lavignes/nop/hw/kicad/nop.kicad_pcb

## KiCad design hw/kicad/nop.kicad_pcb (2026-09-07)

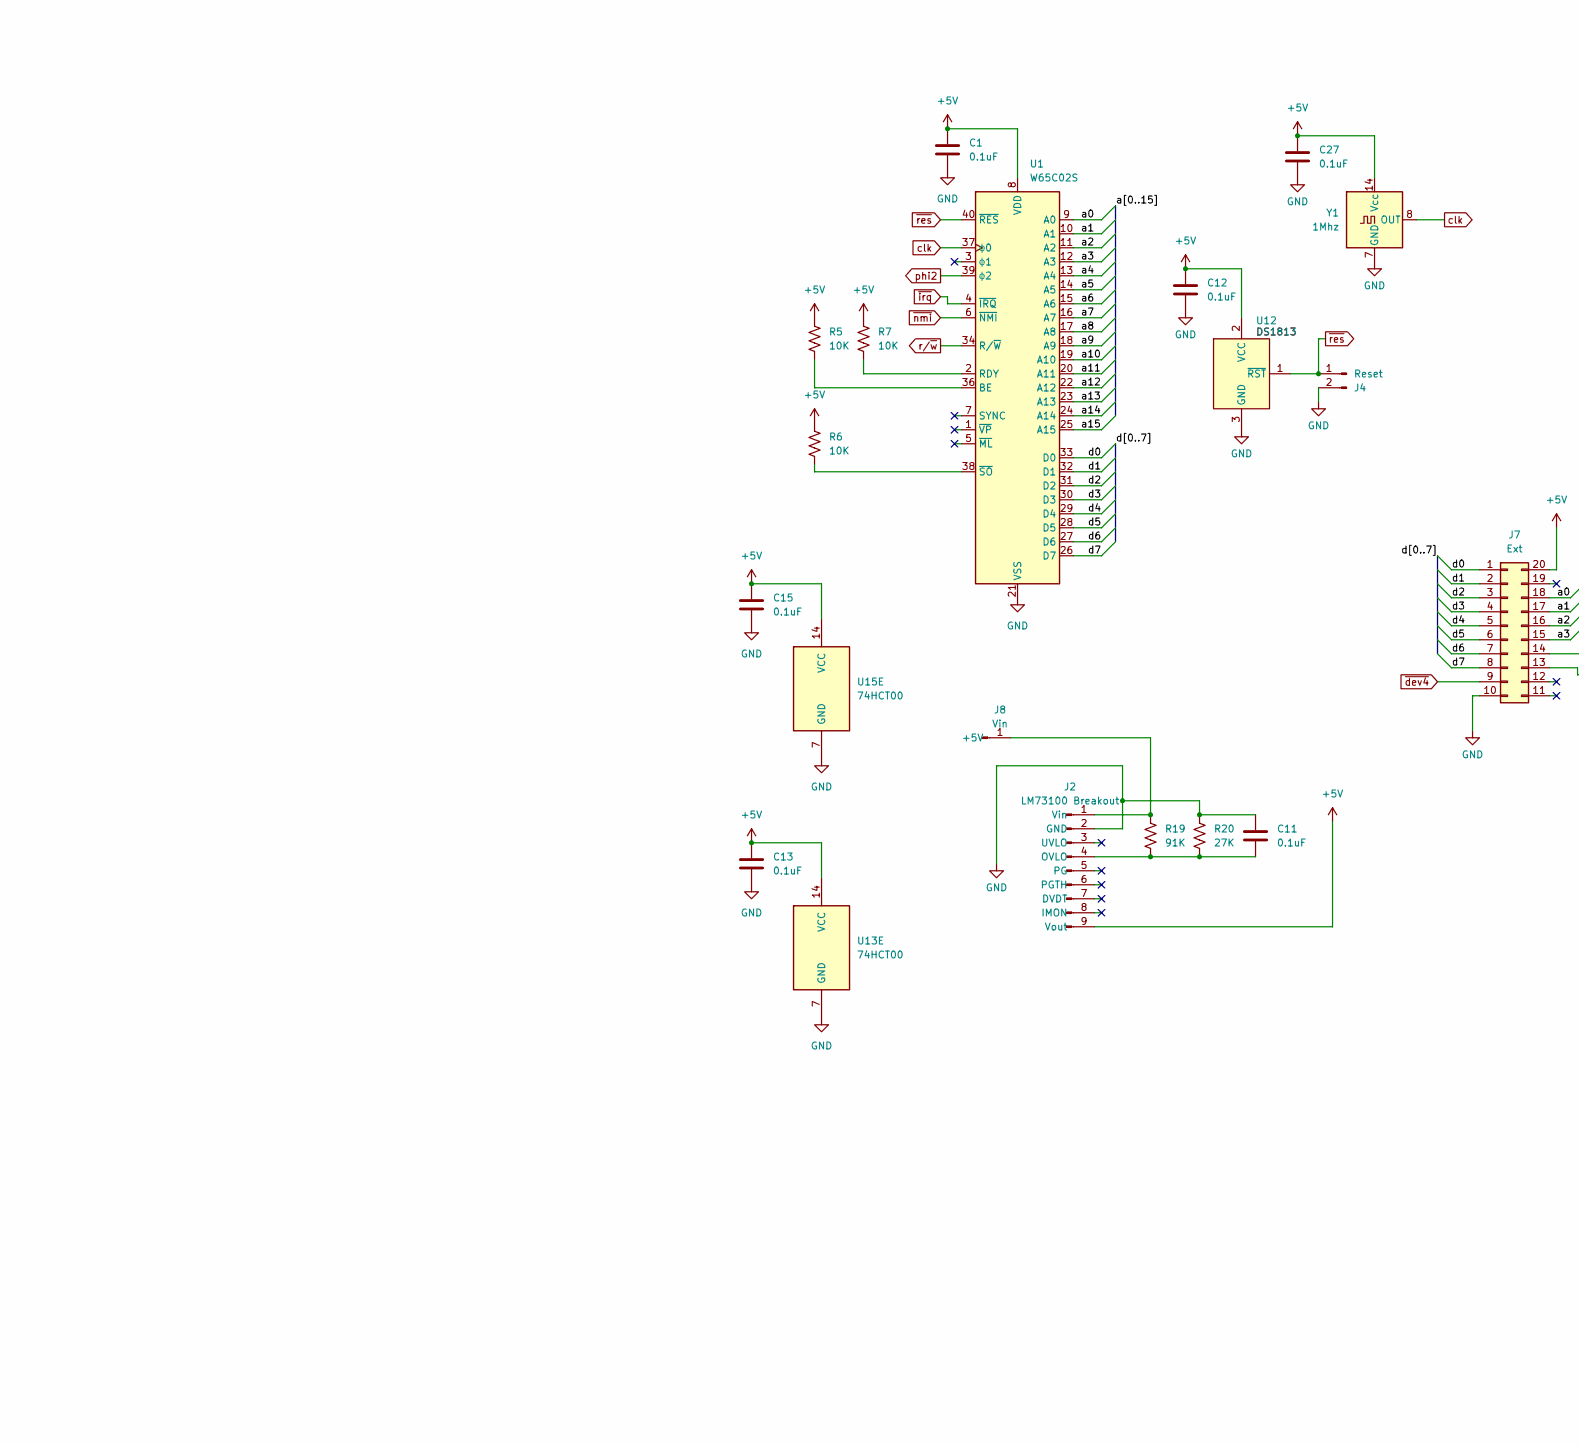
[picture p1: schematic nop.kicad_sch, part in row 1, column 1]

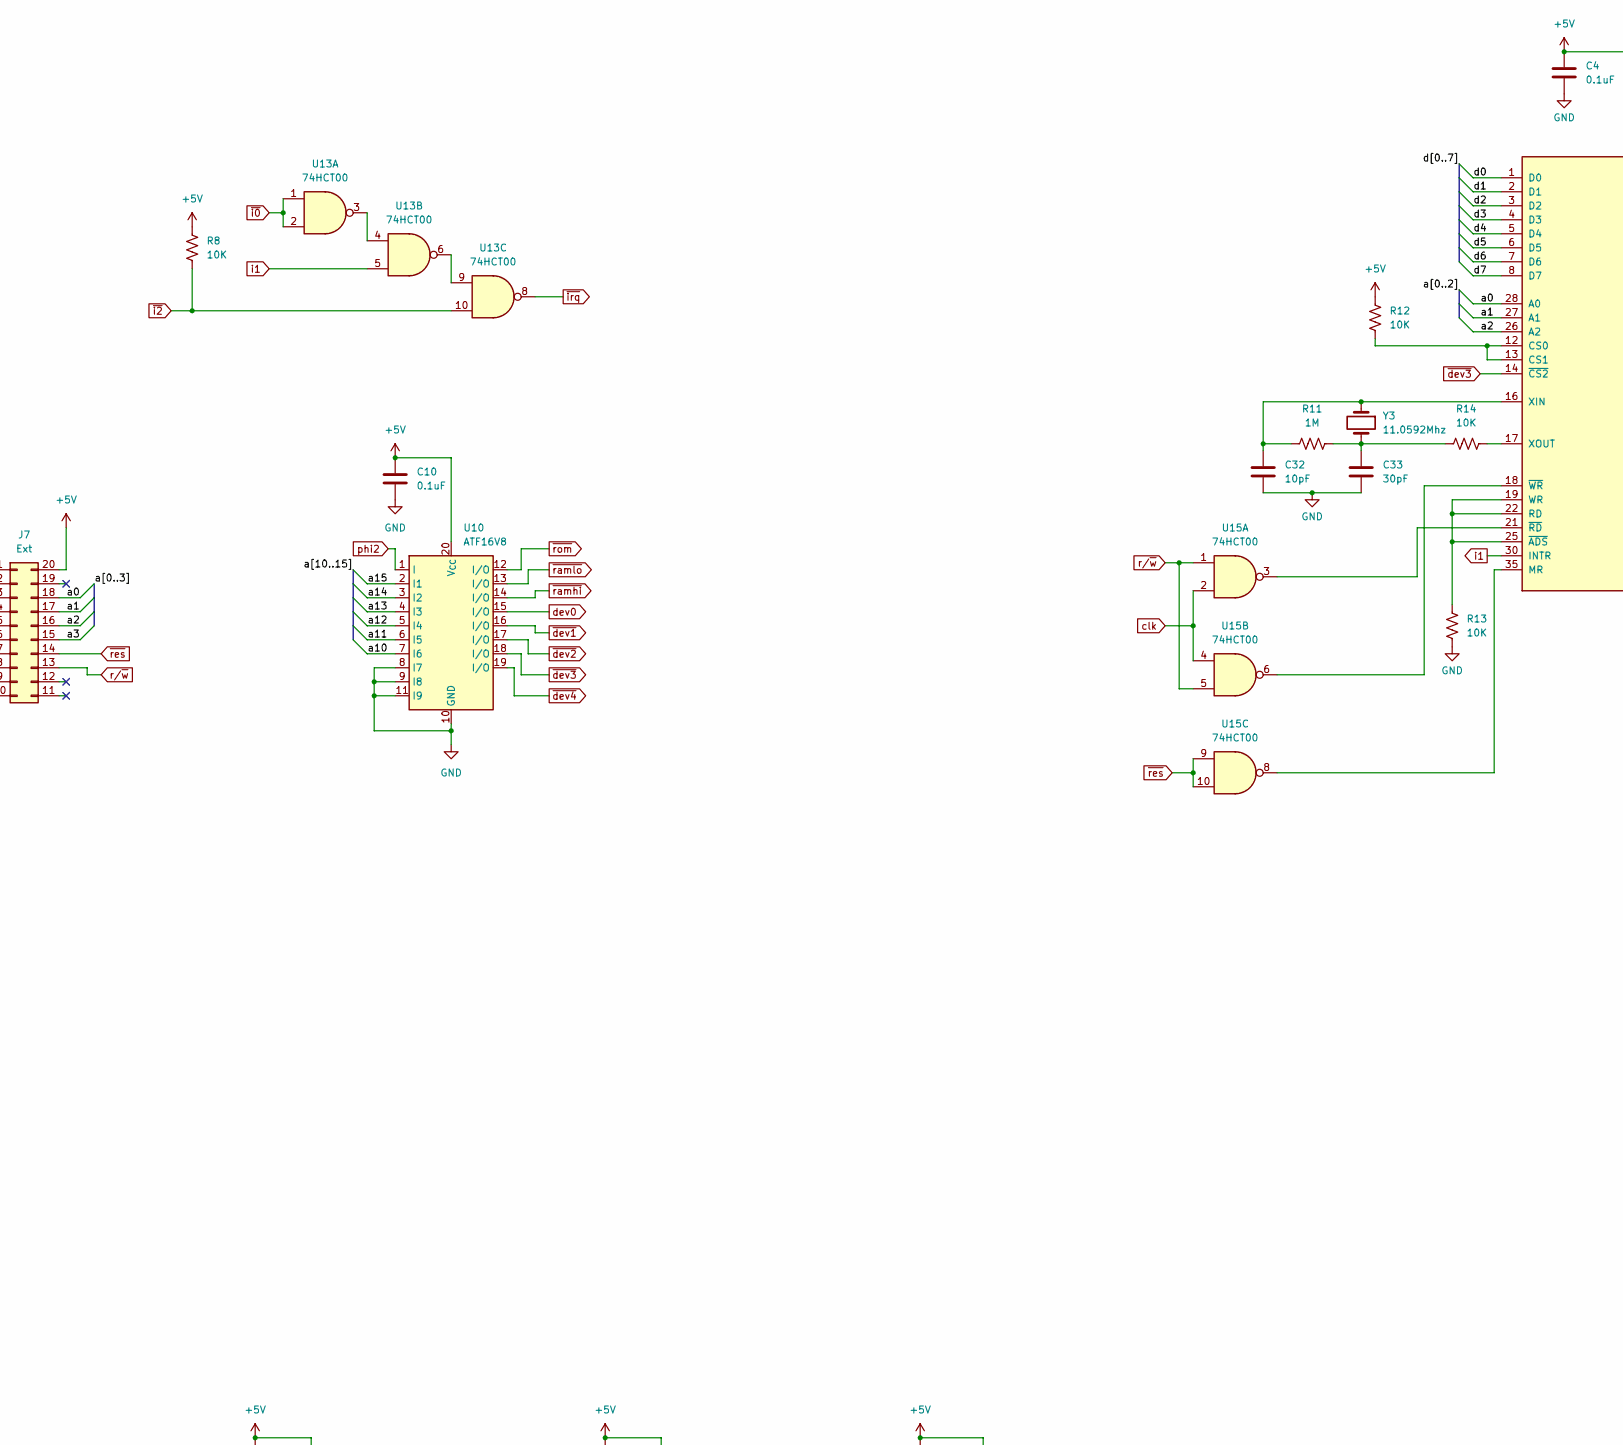
[picture p2: schematic nop.kicad_sch, part in row 1, column 2]

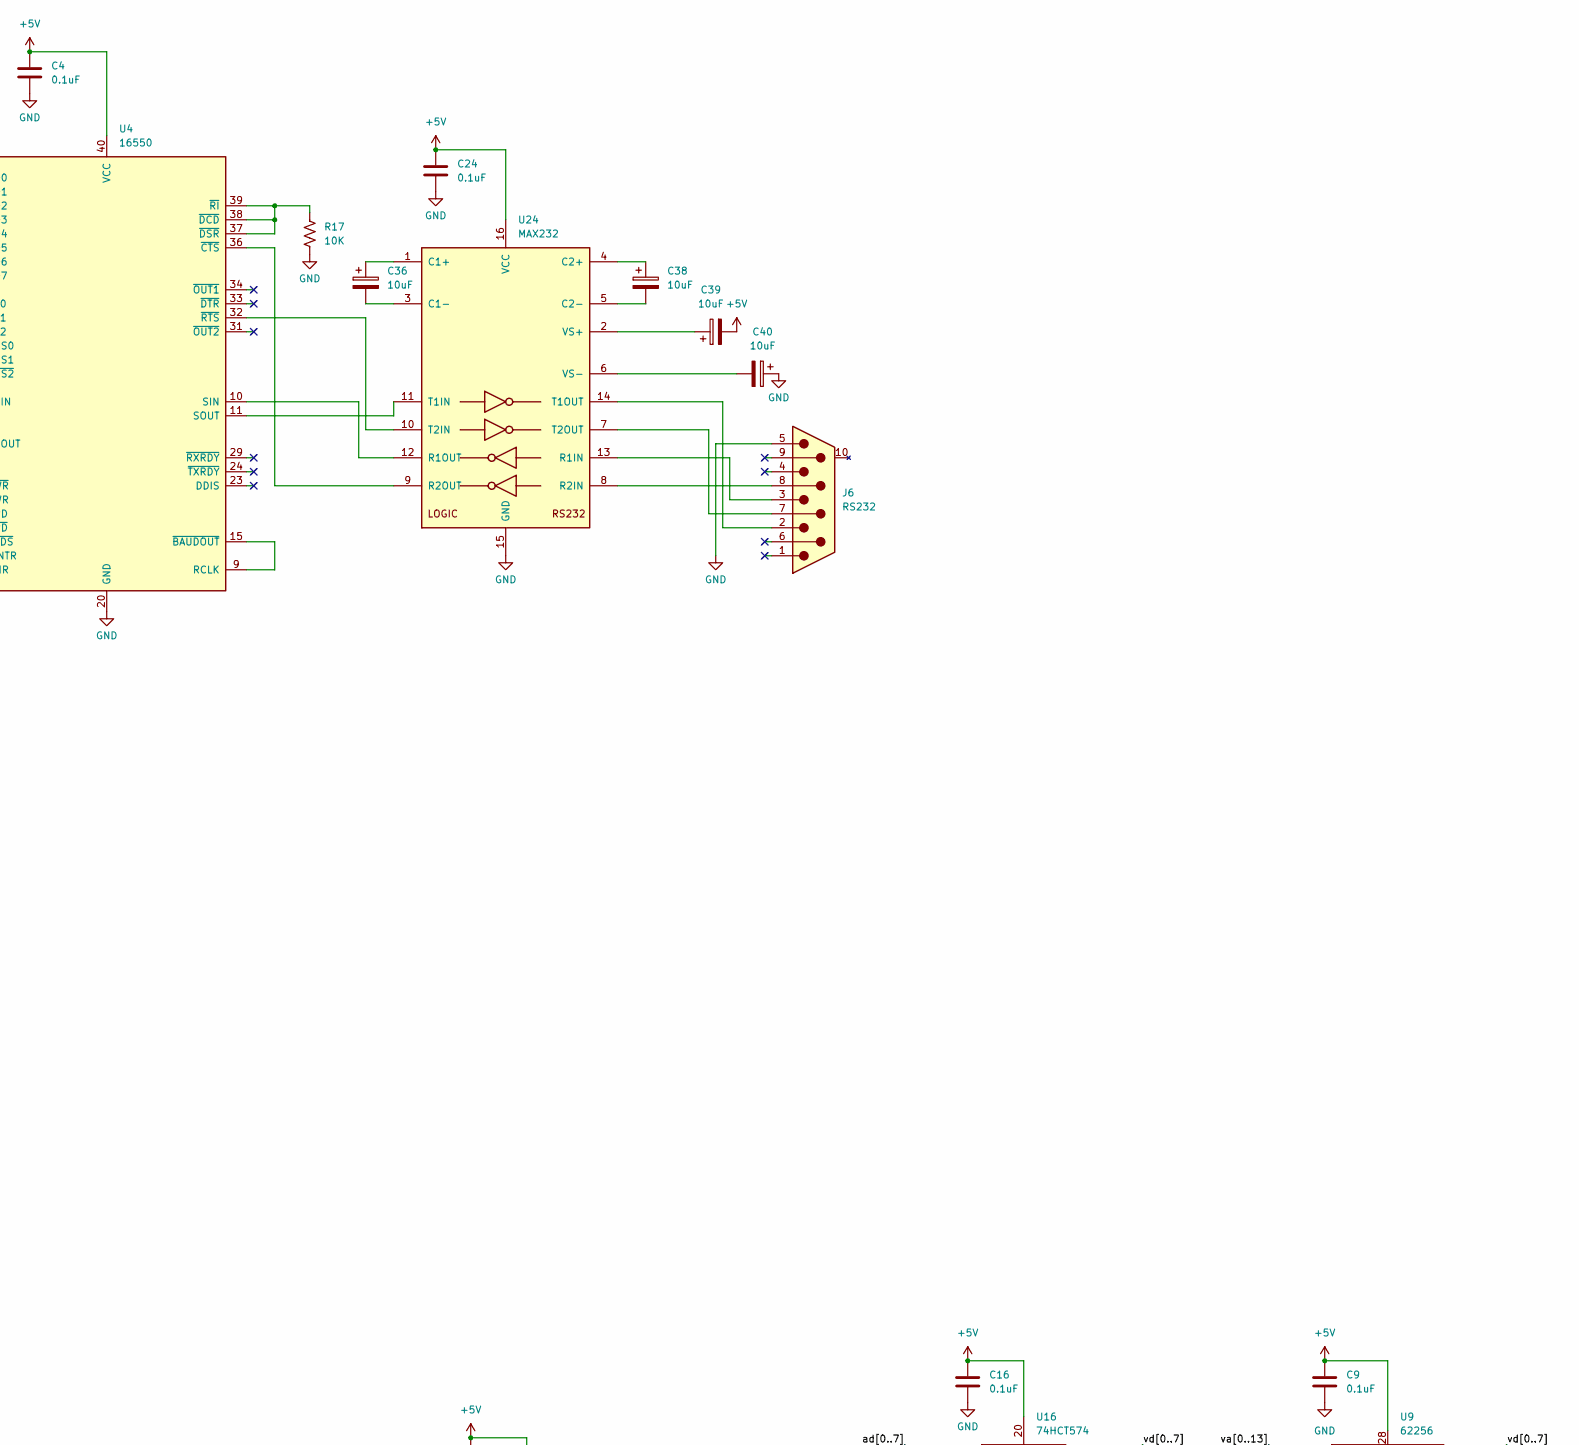
[picture p3: schematic nop.kicad_sch, part in row 1, column 3]

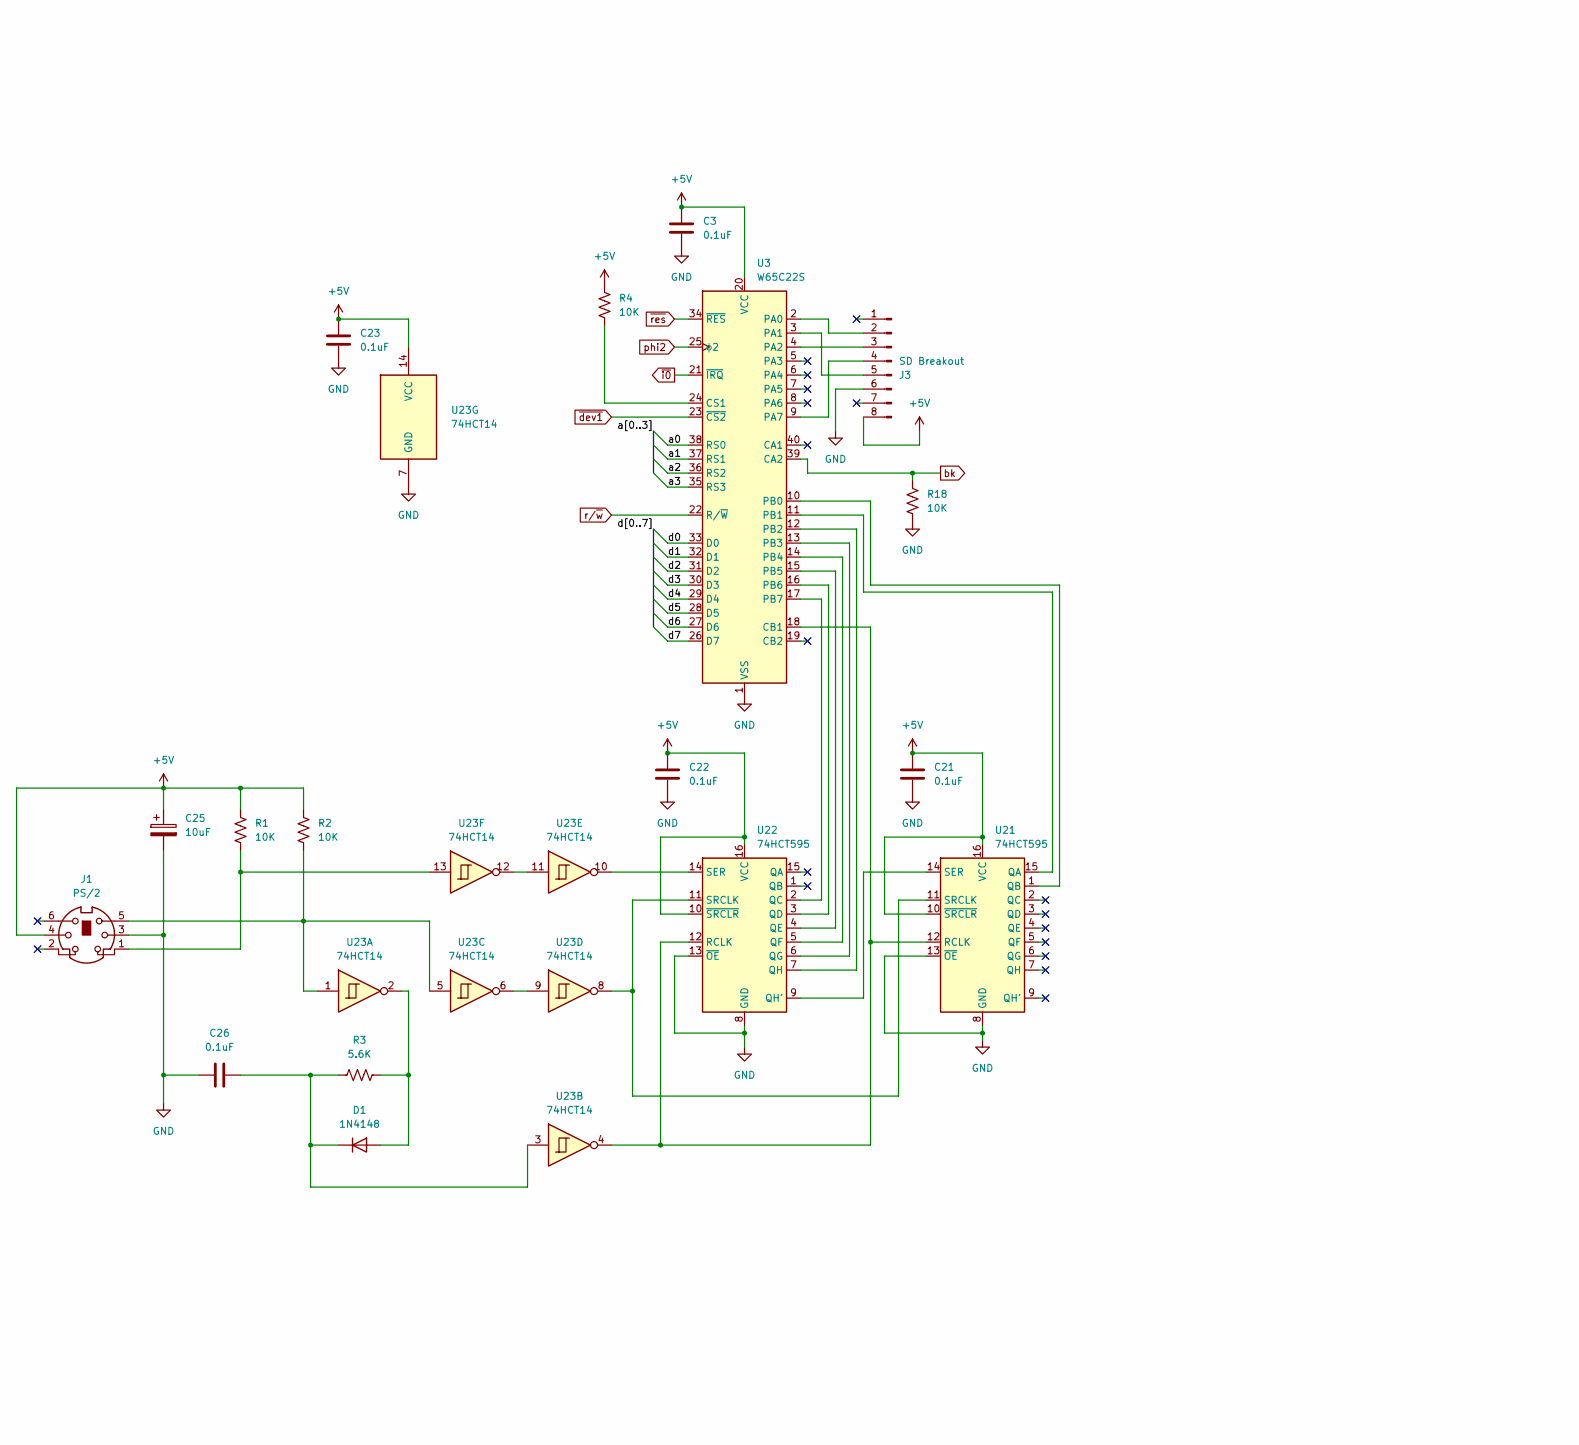
[picture p4: schematic nop.kicad_sch, part in row 2, column 1]

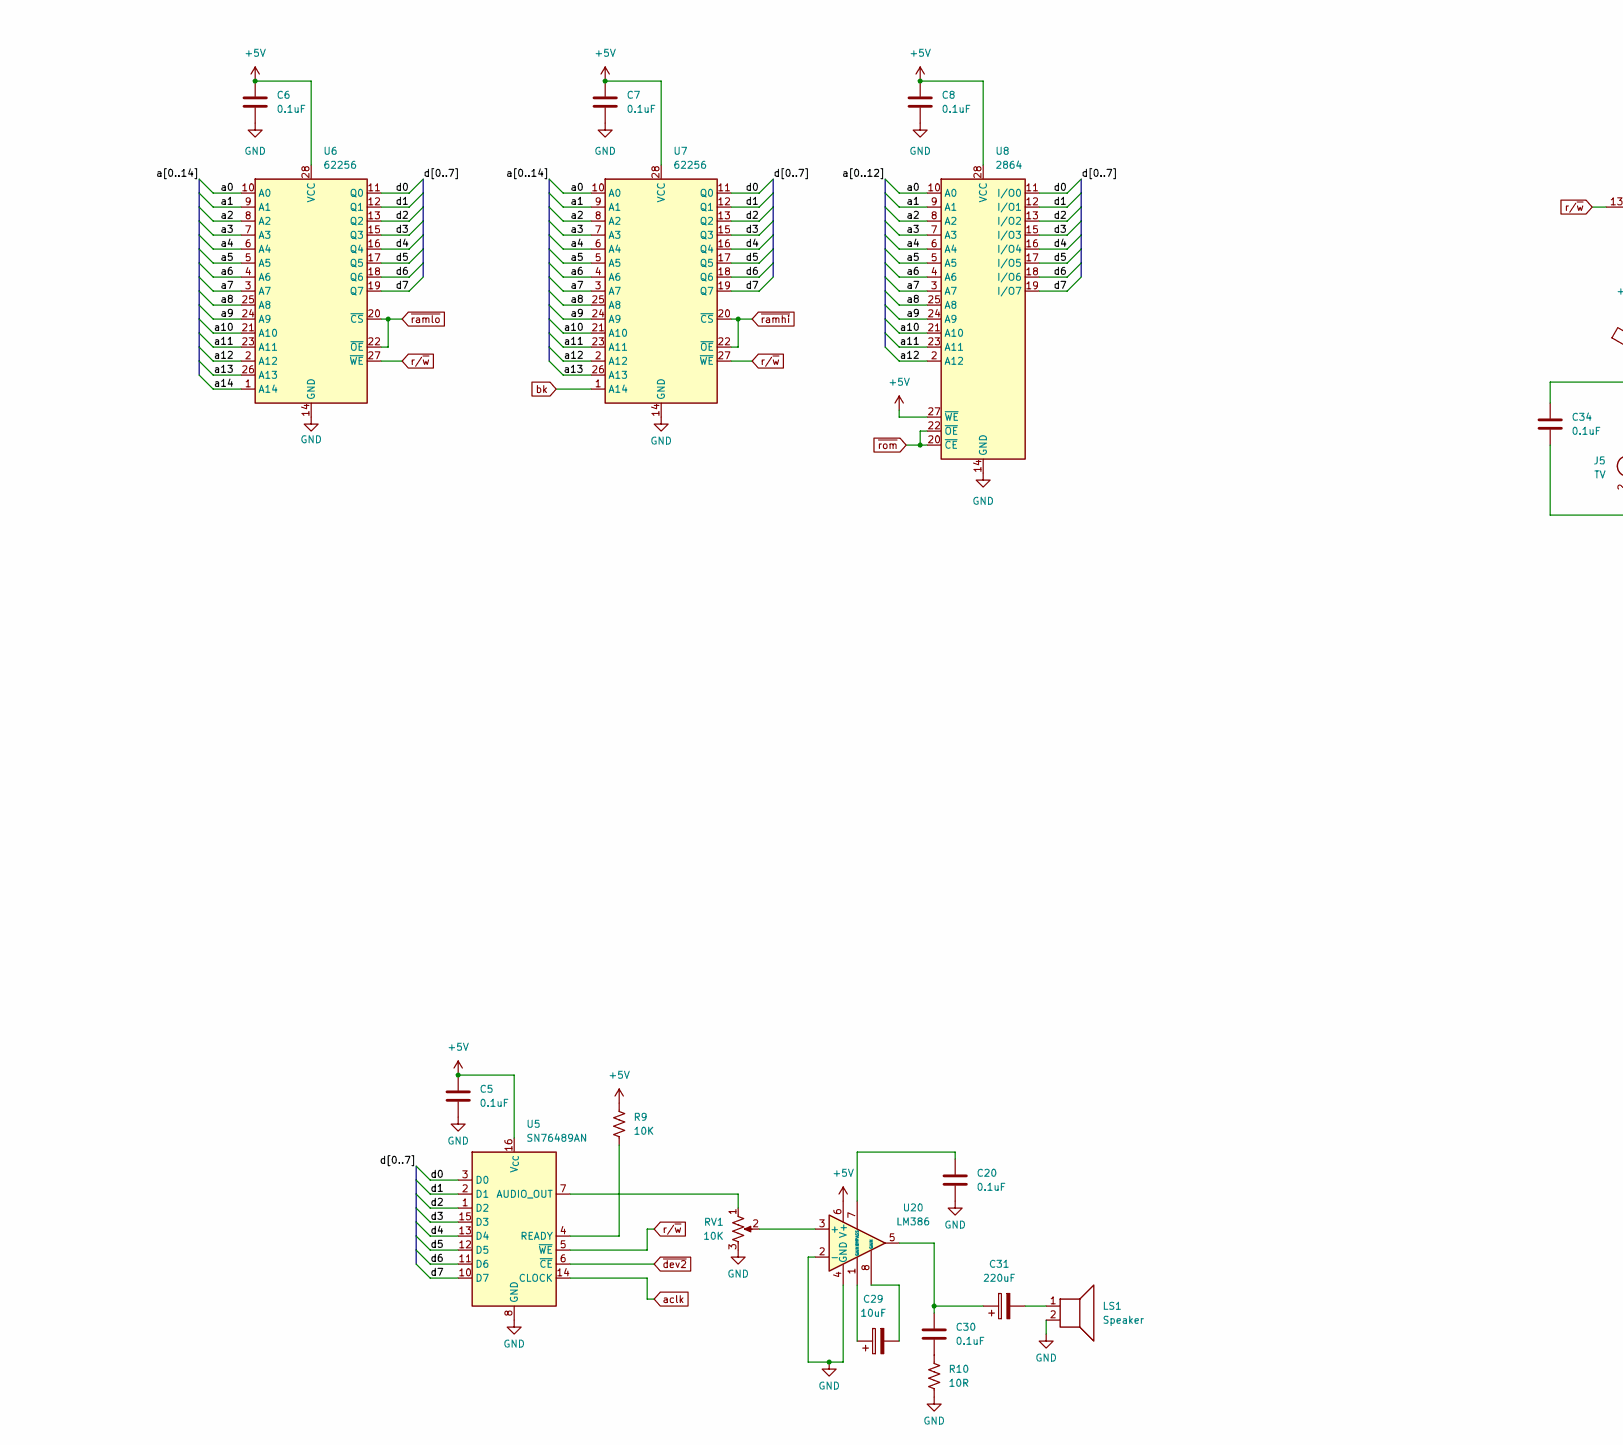
[picture p5: schematic nop.kicad_sch, part in row 2, column 2]

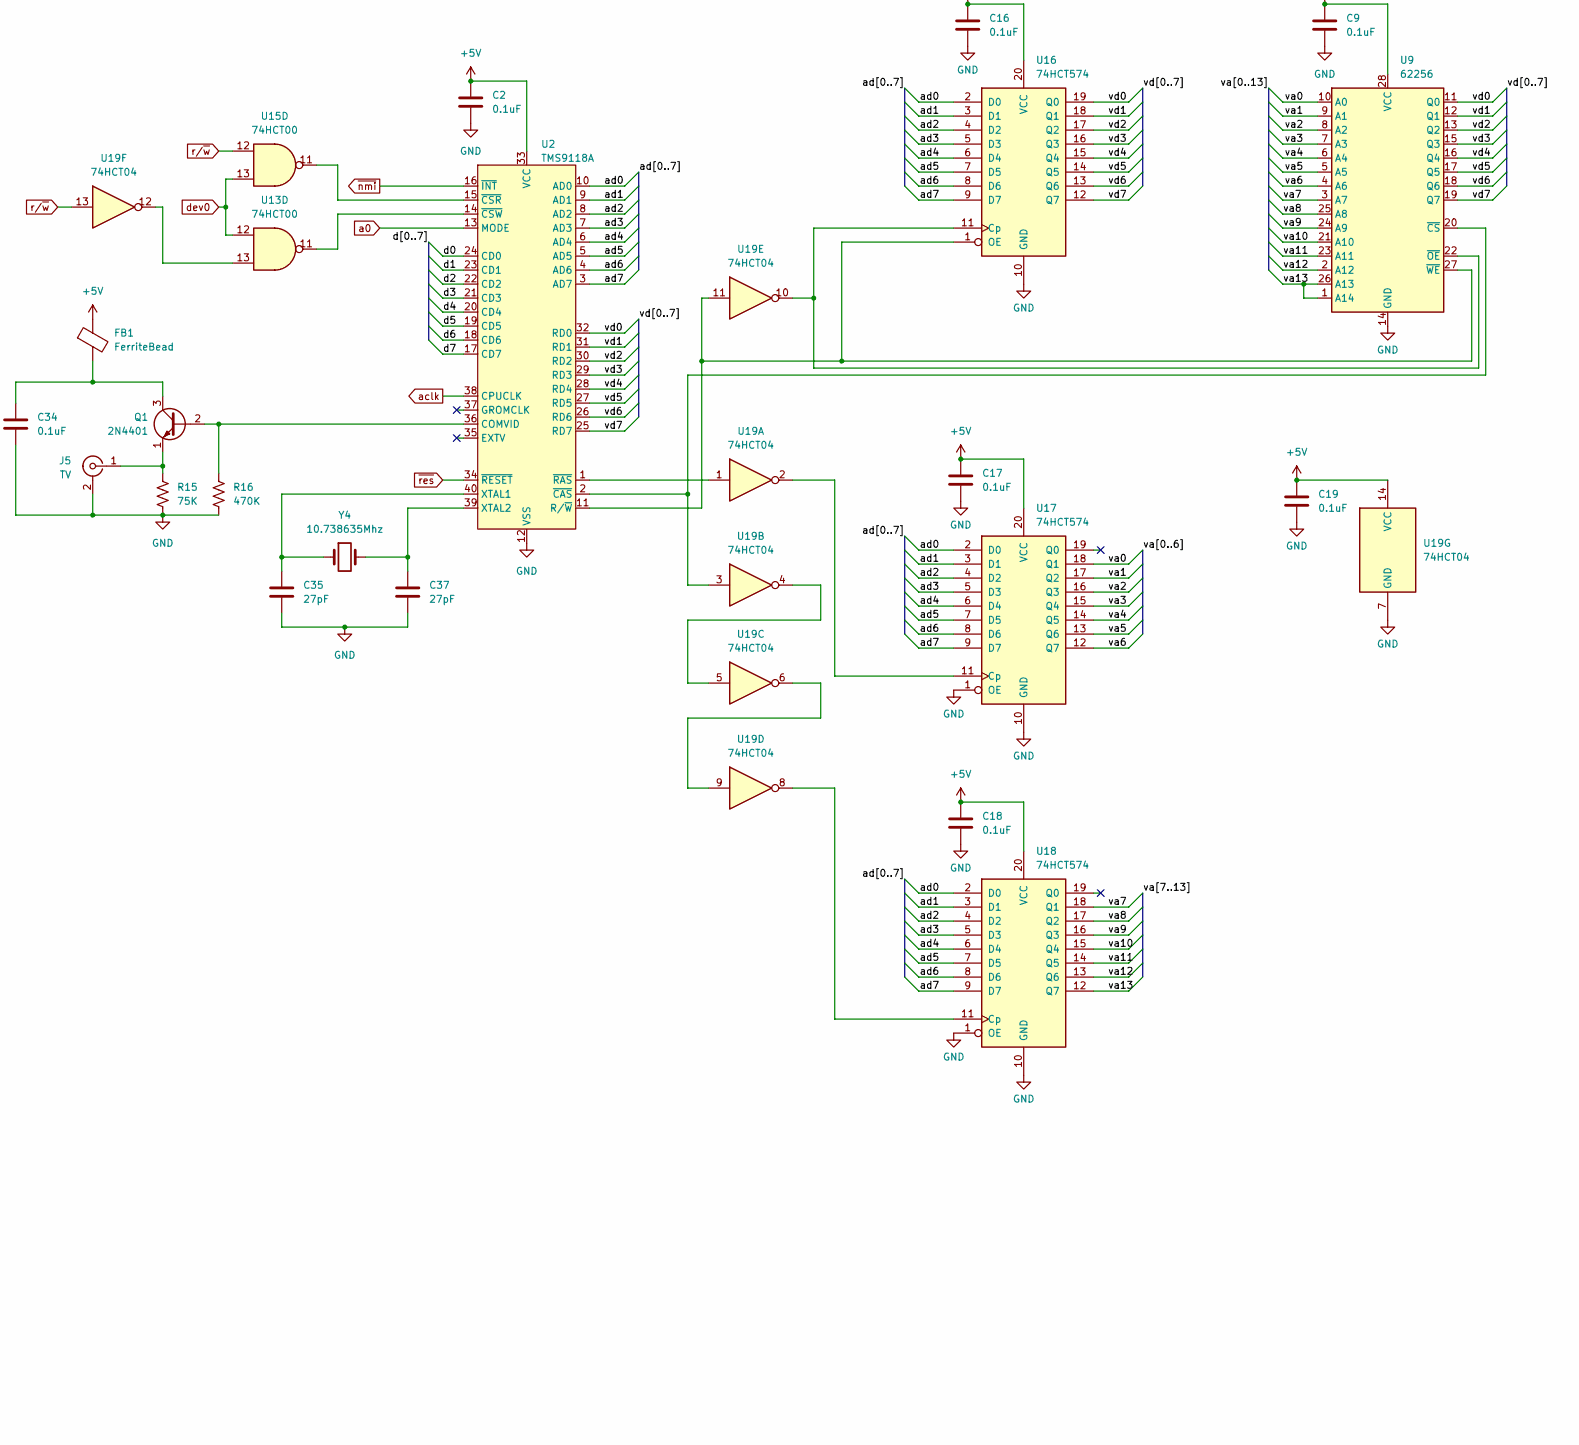
[picture p6: schematic nop.kicad_sch, part in row 2, column 3]

Parts:
C1, C2, C3, C4, C5, C6, C7, C8, C9, C10, C11, C12, C13, C15, C16, C17, C18, C19, C20, C21, C22, C23, C24, C26, C27, C30, C34: 0.1uF; C_Disc_D7.5mm_W4.4mm_P5.00mm
C25, C29, C36, C38, C39, C40: 10uF; CP_Radial_D5.0mm_P2.50mm
C31: 220uF; CP_Radial_D5.0mm_P2.50mm
C32: 10pF; C_Disc_D7.5mm_W4.4mm_P5.00mm
C33: 30pF; C_Disc_D7.5mm_W4.4mm_P5.00mm
C35, C37: 27pF; C_Disc_D7.5mm_W4.4mm_P5.00mm
D1: 1N4148; D_DO-35_SOD27_P7.62mm_Horizontal
FB1: FerriteBead; L_Axial_L5.3mm_D2.2mm_P7.62mm_Horizontal_Vishay_IM-1
J1: PS/2; PinHeader_1x06_P2.54mm_Vertical
J2: LM73100 Breakout; PinHeader_1x09_P2.54mm_Vertical
J3: SD Breakout; PinHeader_1x08_P2.54mm_Vertical
J4: Reset; PinHeader_1x02_P2.54mm_Vertical
J5: TV; PinHeader_1x02_P2.54mm_Vertical
J6: RS232; PinHeader_2x05_P2.54mm_Vertical
J7: Ext; PinHeader_2x10_P2.54mm_Vertical
J8: Vin; PinHeader_1x01_P2.54mm_Vertical
LS1: Speaker; PinHeader_1x02_P2.54mm_Vertical
Q1: 2N4401; TO-92
R1, R2, R4, R5, R6, R7, R8, R9, R12, R13, R14, R17, R18: 10K; R_Axial_DIN0204_L3.6mm_D1.6mm_P7.62mm_Horizontal
R3: 5.6K; R_Axial_DIN0204_L3.6mm_D1.6mm_P7.62mm_Horizontal
R10: 10R; R_Axial_DIN0204_L3.6mm_D1.6mm_P7.62mm_Horizontal
R11: 1M; R_Axial_DIN0204_L3.6mm_D1.6mm_P7.62mm_Horizontal
R15: 75K; R_Axial_DIN0204_L3.6mm_D1.6mm_P7.62mm_Horizontal
R16: 470K; R_Axial_DIN0204_L3.6mm_D1.6mm_P7.62mm_Horizontal
R19: 91K; R_Axial_DIN0204_L3.6mm_D1.6mm_P7.62mm_Horizontal
R20: 27K; R_Axial_DIN0204_L3.6mm_D1.6mm_P7.62mm_Horizontal
RV1: 10K; PinHeader_1x03_P2.54mm_Vertical
U1: W65C02S; DIP-40_W15.24mm_Socket
U2: TMS9118A; DIP-40_W15.24mm_Socket
U3: W65C22S; DIP-40_W15.24mm_Socket
U4: 16550; DIP-40_W15.24mm_Socket
U5: SN76489AN; DIP-16_W7.62mm_Socket
U6, U7, U9: 62256; DIP-28_W15.24mm_Socket
U8: 2864; DIP-28_W15.24mm_Socket
U10: ATF16V8; DIP-20_W7.62mm_Socket
U12: DS1813; TO-92
U13, U15: 74HCT00; DIP-14_W7.62mm_Socket
U16, U17, U18: 74HCT574; DIP-20_W7.62mm_Socket
U19: 74HCT04; DIP-14_W7.62mm_Socket
U20: LM386; DIP-8_W7.62mm_Socket
U21, U22: 74HCT595; DIP-16_W7.62mm_Socket
U23: 74HCT14; DIP-14_W7.62mm_Socket
U24: MAX232; DIP-16_W7.62mm_Socket
Y1: 1Mhz; Oscillator_DIP-14
Y3: 11.0592Mhz; Crystal_HC49-4H_Vertical
Y4: 10.738635Mhz; Crystal_HC49-4H_Vertical

Connections:
+5V: C1.1, C2.1, C3.1, C4.1, C5.1, C6.1, C7.1, C8.1, C9.1, C10.1, C12.1, C13.1, C15.1, C16.1, C17.1, C18.1, C19.1, C21.1, C22.1, C23.1, C24.1, C25.1, C27.1, C39.2, FB1.1, J1.4, J2.9 (Vout), J3.8 (5v), J7.20, R1.2, R2.2, R4.2, R5.2, R6.2, R7.2, R8.2, R9.2, R12.2, U1.8 (VDD), U2.33 (VCC), U3.20 (VCC), U4.40 (VCC), U5.16 (V_{CC}), U6.28 (VCC), U7.28 (VCC), U8.27 (~WE), U8.28 (VCC), U9.28 (VCC), U10.20 (V_{CC}), U12.2 (VCC), U13.14 (VCC), U15.14 (VCC), U16.20 (VCC), U17.20 (VCC), U18.20 (VCC), U19.14 (VCC), U20.6 (V+), U21.10 (~SRCLR), U21.16 (VCC), U22.10 (~SRCLR), U22.16 (VCC), U23.14 (VCC), U24.16 (VCC), Y1.14 (Vcc)
/a1: J7.17, U1.10 (A1), U3.37 (RS1), U4.27 (A1), U6.9 (A1), U7.9 (A1), U8.9 (A1)
/a2: J7.16, U1.11 (A2), U3.36 (RS2), U4.26 (A2), U6.8 (A2), U7.8 (A2), U8.8 (A2)
/a3: J7.15, U1.12 (A3), U3.35 (RS3), U6.7 (A3), U7.7 (A3), U8.7 (A3)
/a4: U1.13 (A4), U6.6 (A4), U7.6 (A4), U8.6 (A4)
/a5: U1.14 (A5), U6.5 (A5), U7.5 (A5), U8.5 (A5)
/a6: U1.15 (A6), U6.4 (A6), U7.4 (A6), U8.4 (A6)
/a7: U1.16 (A7), U6.3 (A7), U7.3 (A7), U8.3 (A7)
/a8: U1.17 (A8), U6.25 (A8), U7.25 (A8), U8.25 (A8)
/a9: U1.18 (A9), U6.24 (A9), U7.24 (A9), U8.24 (A9)
/a10: U1.19 (A10), U6.21 (A10), U7.21 (A10), U8.21 (A10), U10.7 (I6)
/a11: U1.20 (A11), U6.23 (A11), U7.23 (A11), U8.23 (A11), U10.6 (I5)
/a12: U1.22 (A12), U6.2 (A12), U7.2 (A12), U8.2 (A12), U10.5 (I4)
/a13: U1.23 (A13), U6.26 (A13), U7.26 (A13), U10.4 (I3)
/a14: U1.24 (A14), U6.1 (A14), U10.3 (I2)
/a15: U1.25 (A15), U10.2 (I1)
/ad0: U2.10 (AD0), U16.2 (D0), U17.2 (D0), U18.2 (D0)
/ad1: U2.9 (AD1), U16.3 (D1), U17.3 (D1), U18.3 (D1)
/ad2: U2.8 (AD2), U16.4 (D2), U17.4 (D2), U18.4 (D2)
/ad3: U2.7 (AD3), U16.5 (D3), U17.5 (D3), U18.5 (D3)
/ad4: U2.6 (AD4), U16.6 (D4), U17.6 (D4), U18.6 (D4)
/ad5: U2.5 (AD5), U16.7 (D5), U17.7 (D5), U18.7 (D5)
/ad6: U2.4 (AD6), U16.8 (D6), U17.8 (D6), U18.8 (D6)
/ad7: U2.3 (AD7), U16.9 (D7), U17.9 (D7), U18.9 (D7)
/d0: J7.1, U1.33 (D0), U2.24 (CD0), U3.33 (D0), U4.1 (D0), U5.3 (D0), U6.11 (Q0), U7.11 (Q0), U8.11 (I/O0)
/d1: J7.2, U1.32 (D1), U2.23 (CD1), U3.32 (D1), U4.2 (D1), U5.2 (D1), U6.12 (Q1), U7.12 (Q1), U8.12 (I/O1)
/d2: J7.3, U1.31 (D2), U2.22 (CD2), U3.31 (D2), U4.3 (D2), U5.1 (D2), U6.13 (Q2), U7.13 (Q2), U8.13 (I/O2)
/d3: J7.4, U1.30 (D3), U2.21 (CD3), U3.30 (D3), U4.4 (D3), U5.15 (D3), U6.15 (Q3), U7.15 (Q3), U8.15 (I/O3)
/d4: J7.5, U1.29 (D4), U2.20 (CD4), U3.29 (D4), U4.5 (D4), U5.13 (D4), U6.16 (Q4), U7.16 (Q4), U8.16 (I/O4)
/d5: J7.6, U1.28 (D5), U2.19 (CD5), U3.28 (D5), U4.6 (D5), U5.12 (D5), U6.17 (Q5), U7.17 (Q5), U8.17 (I/O5)
/d6: J7.7, U1.27 (D6), U2.18 (CD6), U3.27 (D6), U4.7 (D6), U5.11 (D6), U6.18 (Q6), U7.18 (Q6), U8.18 (I/O6)
/d7: J7.8, U1.26 (D7), U2.17 (CD7), U3.26 (D7), U4.8 (D7), U5.10 (D7), U6.19 (Q7), U7.19 (Q7), U8.19 (I/O7)
/va0: U9.10 (A0), U17.18 (Q1)
/va1: U9.9 (A1), U17.17 (Q2)
/va2: U9.8 (A2), U17.16 (Q3)
/va3: U9.7 (A3), U17.15 (Q4)
/va4: U9.6 (A4), U17.14 (Q5)
/va5: U9.5 (A5), U17.13 (Q6)
/va6: U9.4 (A6), U17.12 (Q7)
/va7: U9.3 (A7), U18.18 (Q1)
/va8: U9.25 (A8), U18.17 (Q2)
/va9: U9.24 (A9), U18.16 (Q3)
/va10: U9.21 (A10), U18.15 (Q4)
/va11: U9.23 (A11), U18.14 (Q5)
/va12: U9.2 (A12), U18.13 (Q6)
/va13: U9.1 (A14), U9.26 (A13), U18.12 (Q7)
/vd0: U2.32 (RD0), U9.11 (Q0), U16.19 (Q0)
/vd1: U2.31 (RD1), U9.12 (Q1), U16.18 (Q1)
/vd2: U2.30 (RD2), U9.13 (Q2), U16.17 (Q2)
/vd3: U2.29 (RD3), U9.15 (Q3), U16.16 (Q3)
/vd4: U2.28 (RD4), U9.16 (Q4), U16.15 (Q4)
/vd5: U2.27 (RD5), U9.17 (Q5), U16.14 (Q5)
/vd6: U2.26 (RD6), U9.18 (Q6), U16.13 (Q6)
/vd7: U2.25 (RD7), U9.19 (Q7), U16.12 (Q7)
GND: C1.2, C2.2, C3.2, C4.2, C5.2, C6.2, C7.2, C8.2, C9.2, C10.2, C11.1, C12.2, C13.2, C15.2, C16.2, C17.2, C18.2, C19.2, C20.2, C21.2, C22.2, C23.2, C24.2, C25.2, C26.1, C27.2, C32.2, C33.2, C34.2, C35.2, C37.2, C40.1, J1.3, J2.2 (GND), J3.6 (GND), J4.2, J5.2 (Ext), J6.5, J7.10, LS1.2, R10.1, R13.1, R15.1, R16.1, R17.1, R18.1, R20.2, RV1.3, U1.21 (VSS), U2.12 (VSS), U3.1 (VSS), U4.20 (GND), U5.8 (GND), U6.14 (GND), U7.14 (GND), U8.14 (GND), U9.14 (GND), U10.8 (I7), U10.9 (I8), U10.10 (GND), U10.11 (I9), U12.3 (GND), U13.7 (GND), U15.7 (GND), U16.10 (GND), U17.1 (OE), U17.10 (GND), U18.1 (OE), U18.10 (GND), U19.7 (GND), U20.2 (-), U20.4 (GND), U21.8 (GND), U21.13 (~OE), U22.8 (GND), U22.13 (~OE), U23.7 (GND), U24.15 (GND), Y1.7 (GND)
unnamed: C29.1, U20.1 (GAIN)
unnamed: C29.2, U20.8 (GAIN)
unnamed: C30.1, C31.1, U20.5
unnamed: C30.2, R10.2
unnamed: C31.2, LS1.1
unnamed: C33.1, R11.1, R14.2, Y3.2
unnamed: D1.2 (A), R3.1, U23.2
unnamed: C26.2, D1.1 (K), R3.2, U23.3
unnamed: J1.1, R1.1, U23.13
unnamed: J1.5, R2.1, U23.1, U23.5
unnamed: C11.2, J2.4 (OVLO), R19.1, R20.1
unnamed: J2.1 (Vin), J8.1, R19.2
unnamed: J3.5 (CLK), U3.3 (PA1)
unnamed: J3.2 (CS), U3.2 (PA0)
unnamed: J3.3 (DI), U3.4 (PA2)
unnamed: J3.4 (DO), U3.9 (PA7)
unnamed: J5.1 (In), Q1.1 (E), R15.2
unnamed: Q1.2 (B), R16.2, U2.36 (COMVID)
unnamed: C34.1, FB1.2, Q1.3 (C)
unnamed: R5.1, U1.36 (BE)
unnamed: R7.1, U1.2 (RDY)
unnamed: R6.1, U1.38 (~SO)
unnamed: C35.1, U2.40 (XTAL1), Y4.1
unnamed: C37.1, U2.39 (XTAL2), Y4.2
unnamed: U2.2 (~CAS), U9.20 (~CS), U19.3
unnamed: U2.15 (~CSR), U15.11
unnamed: U2.14 (~CSW), U13.11
unnamed: U2.1 (~RAS), U19.1
unnamed: R4.1, U3.24 (CS1)
unnamed: R12.1, U4.12 (CS0), U4.13 (CS1)
unnamed: U4.35 (MR), U15.8
unnamed: U4.9 (RCLK), U4.15 (~BAUDOUT)
unnamed: R13.2, U4.19 (WR), U4.22 (RD), U4.25 (~ADS)
unnamed: C32.1, R11.2, U4.16 (XIN), Y3.1
unnamed: R14.1, U4.17 (XOUT)
unnamed: R17.2, U4.37 (~DSR), U4.38 (~DCD), U4.39 (~RI)
unnamed: U4.21 (~RD), U15.3
unnamed: U4.18 (~WR), U15.6
unnamed: RV1.1, U5.7 (AUDIO_OUT)
unnamed: R9.1, U5.4 (READY)
unnamed: U13.3, U13.4
unnamed: U13.6, U13.9
unnamed: U13.13, U19.12
unnamed: U9.22 (~OE), U16.11 (Cp), U19.10
unnamed: U2.11 (R/~W), U9.27 (~WE), U16.1 (OE), U19.11
unnamed: U17.11 (Cp), U19.2
unnamed: U18.11 (Cp), U19.8
unnamed: U19.4, U19.5
unnamed: U19.6, U19.9
unnamed: RV1.2, U20.3 (+)
unnamed: C20.1, U20.7 (BYPASS)
unnamed: U3.11 (PB1), U21.15 (QA)
unnamed: U3.10 (PB0), U21.1 (QB)
unnamed: U3.18 (CB1), U21.12 (RCLK), U22.12 (RCLK), U23.4
unnamed: U21.14 (SER), U22.9 (QH')
unnamed: U21.11 (SRCLK), U22.11 (SRCLK), U23.8
unnamed: U3.17 (PB7), U22.2 (QC)
unnamed: U3.16 (PB6), U22.3 (QD)
unnamed: U3.15 (PB5), U22.4 (QE)
unnamed: U3.14 (PB4), U22.5 (QF)
unnamed: U3.13 (PB3), U22.6 (QG)
unnamed: U3.12 (PB2), U22.7 (QH)
unnamed: U22.14 (SER), U23.10
unnamed: U23.6, U23.9
unnamed: U23.11, U23.12
unnamed: C36.1, U24.1 (C1+)
unnamed: C36.2, U24.3 (C1-)
unnamed: C38.1, U24.4 (C2+)
unnamed: C38.2, U24.5 (C2-)
unnamed: J6.3, U24.13 (R1IN)
unnamed: U4.10 (SIN), U24.12 (R1OUT)
unnamed: J6.8, U24.8 (R2IN)
unnamed: U4.36 (~CTS), U24.9 (R2OUT)
unnamed: U4.11 (SOUT), U24.11 (T1IN)
unnamed: J6.2, U24.14 (T1OUT)
unnamed: U4.32 (~RTS), U24.10 (T2IN)
unnamed: J6.7, U24.7 (T2OUT)
unnamed: C39.1, U24.2 (VS+)
unnamed: C40.2, U24.6 (VS-)
a0: J7.18, U1.9 (A0), U2.13 (MODE), U3.38 (RS0), U4.28 (A0), U6.10 (A0), U7.10 (A0), U8.10 (A0)
aclk: U2.38 (CPUCLK), U5.14 (CLOCK)
bk: R18.2, U3.39 (CA2), U7.1 (A14)
clk: U1.37 (ϕ0), U15.2, U15.4, Y1.8 (OUT)
dev0: U10.15 (I/O), U13.12, U15.13
i1: U4.30 (INTR), U13.5
phi2: U1.39 (ϕ2), U3.25 (ϕ2), U10.1 (I)
r/~w: J7.13, U1.34 (R/~W), U3.22 (R/~W), U5.5 (~WE), U6.27 (~WE), U7.27 (~WE), U15.1, U15.5, U15.12, U19.13
~dev1: U3.23 (~CS2), U10.16 (I/O)
~dev2: U5.6 (~CE), U10.17 (I/O)
~dev3: U4.14 (~CS2), U10.18 (I/O)
~dev4: J7.9, U10.19 (I/O)
~i0: U3.21 (~IRQ), U13.1, U13.2
~i2: R8.1, U13.10
~irq: U1.4 (~IRQ), U13.8
~nmi: U1.6 (~NMI), U2.16 (~INT)
~ramhi: U7.20 (~CS), U7.22 (~OE), U10.14 (I/O)
~ramlo: U6.20 (~CS), U6.22 (~OE), U10.13 (I/O)
~res: J4.1, J7.14, U1.40 (~RES), U2.34 (~RESET), U3.34 (~RES), U12.1 (~RST), U15.9, U15.10
~rom: U8.20 (~CE), U8.22 (~OE), U10.12 (I/O)

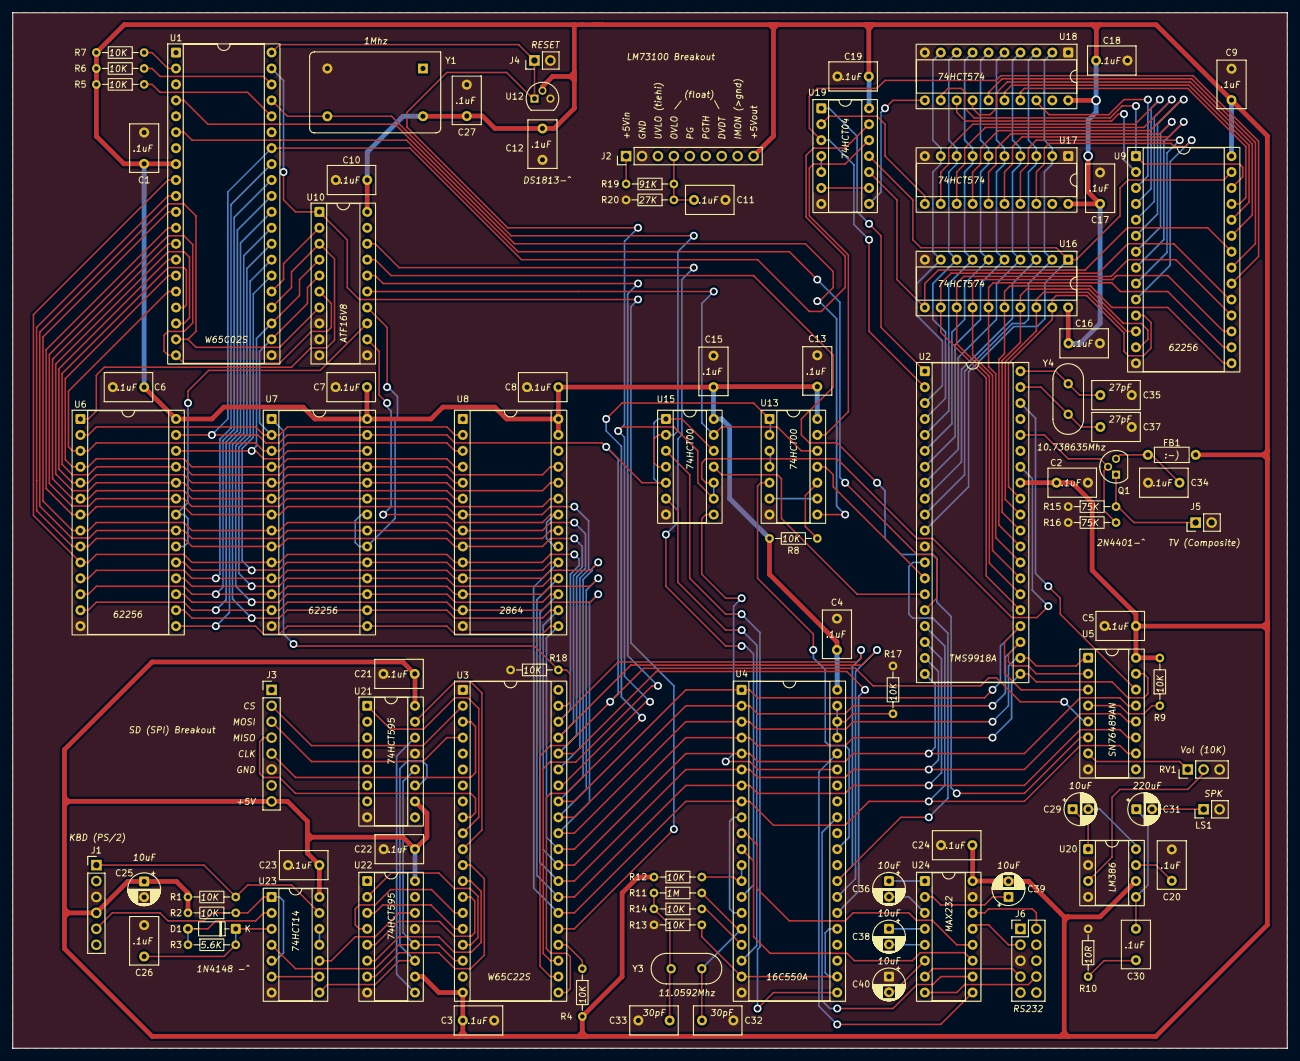
[picture p7: board nop.kicad_pcb from above]

Board: 2 copper layers, 203.2 x 165.1 mm, 94 parts (0 on the bottom side), 153 nets.
