lavignes/nop/vm/vm.c

// stdlib
#include <stddef.h>
#include <stdio.h>
#include <stdlib.h>
#include <string.h>
#include <time.h>

// POSIX
#include <termios.h>
#include <unistd.h>

#include <SDL3/SDL.h>

#include "vm.h"

static void help(char const *name) {
  fprintf(stderr,
          "Usage: %s [options] <rom-file>\n"
          "\n"
          "Options:\n"
          "\n"
          "  -d, --debug              Start in debug mode\n"
          "  -l, --label-list <path>  Load symbol label-list from file\n"
          "  -r, --random             Initialize memory with random data\n"
          "  -i, --image <path>       Attach a disk image\n"
          "  -s, --serial <path>      Attach a serial device or file\n"
          "  -h, --help               Show this help message\n",
          name);
}

static Emu emu = {0};

static struct termios termiosOrig;
static Bool termRawMode = FALSE;

static SDL_Window *win = NULL;
static SDL_Renderer *render = NULL;
static SDL_Texture *tex = NULL;
static SDL_AudioStream *audio = NULL;

enum { AUDIO_BUF_LEN = 4096 };
static I16 audioBuf[AUDIO_BUF_LEN];
static UInt audioLen = 0;

static Bool quit = FALSE;
static UInt cycleCount = 0;
static UInt vdpAccum = 0;
static UInt sampleAccum = 0;
static U64 nextFrameNs = 0;

enum : U64 {
  FRAME_COLS_NTSC = 342,
  FRAME_LINES_NTSC = 262,
  FRAME_TIME_NTSC =
      U64K(1000000000) * FRAME_COLS_NTSC * FRAME_LINES_NTSC / VDP_HZ
};

static void emuReset(Bool random);
static void emuTick();

static void audioFlush();

int main(int argc, char const *const *argv) {
  FILE *rom;
  char const *labelList = NULL;
  char const *diskPath = NULL;
  Bool random = FALSE;

  atexit(termRawModeOff);

  if (argc < 2) {
    help(argv[0]);
    return EXIT_FAILURE;
  }
  for (int argi = 1; argi < argc; ++argi) {
    if ((strcmp(argv[argi], "-h") == 0) ||
        (strcmp(argv[argi], "--help") == 0)) {
      help(argv[0]);
      return EXIT_SUCCESS;
    }
    if ((strcmp(argv[argi], "-d") == 0) ||
        (strcmp(argv[argi], "--debug") == 0)) {
      emu.dbg.debug = TRUE;
      continue;
    }
    if ((strcmp(argv[argi], "-l") == 0) ||
        (strcmp(argv[argi], "--labellist") == 0)) {
      ++argi;
      if (argi == argc) {
        fprintf(stderr, "No labellist file specified\n");
        return EXIT_FAILURE;
      }
      labelList = argv[argi];
      continue;
    }
    if ((strcmp(argv[argi], "-r") == 0) ||
        (strcmp(argv[argi], "--random") == 0)) {
      random = TRUE;
      continue;
    }
    if ((strcmp(argv[argi], "-i") == 0) ||
        (strcmp(argv[argi], "--image") == 0)) {
      ++argi;
      if (argi == argc) {
        fprintf(stderr, "No disk image specified\n");
        return EXIT_FAILURE;
      }
      diskPath = argv[argi];
      continue;
    }
    rom = fopen(argv[argi], "rb");
    if (!rom) {
      fprintf(stderr, "Could not open ROM file: %s\n", argv[argi]);
      return EXIT_FAILURE;
    }
    ++argi;
    if (argi != argc) {
      fprintf(stderr, "Unexpected option: %s\n", argv[argi]);
      return EXIT_FAILURE;
    }
  }

  if (!rom) {
    fprintf(stderr, "No ROM file specified\n");
    return EXIT_FAILURE;
  }

  if (random) {
    srand(time(NULL));
  }

  UInt read = fread(emu.rom, 1, sizeof(emu.rom), rom);
  if (read != sizeof(emu.rom)) {
    int err = ferror(rom);
    if (err) {
      fprintf(stderr, "Error reading ROM file: %s\n", strerror(err));
      return EXIT_FAILURE;
    }
  }
  fclose(rom);

  if (labelList) {
    symLoad(&emu.dbg, labelList);
  }

  if (!emu.dbg.debug) {
    termRawModeOn();
  }

  int exitCode = EXIT_FAILURE;
  if (!SDL_InitSubSystem(SDL_INIT_VIDEO | SDL_INIT_EVENTS | SDL_INIT_AUDIO)) {
    fprintf(stderr, "SDL_InitSubSystem failed: %s\n", SDL_GetError());
    goto cleanupSDL;
  }
  if (!SDL_CreateWindowAndRenderer("nop", SCREEN_WIDTH * 3, SCREEN_HEIGHT * 3,
                                   SDL_WINDOW_HIGH_PIXEL_DENSITY |
                                       SDL_WINDOW_RESIZABLE,
                                   &win, &render)) {
    fprintf(stderr, "SDL_CreateWindowAndRenderer failed: %s\n", SDL_GetError());
    goto cleanupWindow;
  }
  if (!SDL_ShowWindow(win)) {
    fprintf(stderr, "SDL_ShowWindow failed: %s\n", SDL_GetError());
    goto cleanupWindow;
  }
  if (!SDL_SetRenderVSync(render, 1)) {
    fprintf(stderr, "SDL_SetRenderVSync failed: %s\n", SDL_GetError());
  }
  tex = SDL_CreateTexture(render, SDL_PIXELFORMAT_RGBA8888,
                          SDL_TEXTUREACCESS_STREAMING, SCREEN_WIDTH,
                          SCREEN_HEIGHT);
  if (!tex) {
    fprintf(stderr, "SDL_CreateTexture failed: %s\n", SDL_GetError());
    goto cleanupTexture;
  }

  SDL_AudioSpec spec = {SDL_AUDIO_S16, 1, SAMPLE_RATE};
  audio = SDL_OpenAudioDeviceStream(SDL_AUDIO_DEVICE_DEFAULT_PLAYBACK, &spec,
                                    NULL, NULL);
  if (!audio) {
    fprintf(stderr, "SDL_OpenAudioDeviceStream failed: %s\n", SDL_GetError());
    goto cleanupAudio;
  }
  SDL_ResumeAudioStreamDevice(audio);

  if (diskPath) {
    emu.sd.file = fopen(diskPath, "r+b");
    if (!emu.sd.file) {
      fprintf(stderr, "Could not open disk image: %s\n", diskPath);
      goto cleanup;
    }
  }

  emuReset(random);
  while (!quit) {
    emuTick();
  }
  exitCode = EXIT_SUCCESS;

cleanup:
cleanupAudio:
  if (audio) {
    SDL_DestroyAudioStream(audio);
  }
cleanupTexture:
  if (tex) {
    SDL_DestroyTexture(tex);
  }
cleanupWindow:
  if (render) {
    SDL_DestroyRenderer(render);
  }
  if (win) {
    SDL_DestroyWindow(win);
  }
cleanupSDL:
  SDL_Quit();
  return exitCode;
}

static void vblank() {
  SDL_Event event;
  while (SDL_PollEvent(&event)) {
    switch (event.type) {
    case SDL_EVENT_QUIT:
      quit = TRUE;
      break;
    case SDL_EVENT_KEY_DOWN:
      switch (event.key.key) {
      case SDLK_F3:
        emu.dbg.debug = TRUE;
        break;
      case SDLK_F5:
        emuReset(TRUE);
        break;
      default:
        ps2Key(&emu.ps2, event.key.scancode, TRUE);
      }
      break;
    case SDL_EVENT_KEY_UP:
      switch (event.key.key) {
      case SDLK_F3:
      case SDLK_F5:
        break;
      default:
        ps2Key(&emu.ps2, event.key.scancode, FALSE);
      }
      break;
    }
  }

  audioFlush();

  void *pixels;
  int pitch;
  SDL_LockTexture(tex, NULL, &pixels, &pitch);
  memcpy(pixels, emu.vdp.pix, sizeof(emu.vdp.pix));
  SDL_UnlockTexture(tex);
  SDL_RenderClear(render);
  SDL_RenderTexture(render, tex, NULL, NULL);
  SDL_RenderPresent(render);

  static U64 lastNs = 0;
  static UInt fps = 0;
  ++fps;
  U64 nowNs = SDL_GetTicksNS();
  if ((nowNs - lastNs) >= U64K(1000000000)) {
    char title[64];
    snprintf(title, sizeof(title), "nop - %" UINT_FMT " fps - %.2f MHz", fps,
             ((F64)cycleCount) / 1000000.0);
    SDL_SetWindowTitle(win, title);
    fps = 0;
    cycleCount = 0;
    lastNs = nowNs;
  }

  if (nowNs < nextFrameNs) {
    SDL_DelayNS(nextFrameNs - nowNs);
    nextFrameNs += FRAME_TIME_NTSC;
  } else {
    nextFrameNs = nowNs + FRAME_TIME_NTSC;
  }
}

static void emuReset(Bool random) {
  emu.nmi = FALSE;
  if (random) {
    for (UInt i = 0; i < sizeof(emu.ramlo); ++i) {
      emu.ramlo[i] = rand();
    }
    for (UInt j = 0; j < 2; ++j) {
      for (UInt i = 0; i < sizeof(emu.ramhi[j]); ++i) {
        emu.ramhi[j][i] = rand();
      }
    }
  }
  cpuReset(&emu.cpu, &emu);
  vdpReset(&emu.vdp, &emu, random);
  viaReset(&emu.via);
  psgReset(&emu.psg);
  ps2Reset(&emu.ps2);
  sdReset(&emu.sd);
  uartReset(&emu.uart);
}

static void audioFlush() {
  if (audio && audioLen) {
    SDL_PutAudioStreamData(audio, audioBuf, (int)(audioLen * sizeof(I16)));
    audioLen = 0;
  }
}

static void emuTick() {
  dbgTick(&emu.dbg, &emu);
  UInt cycles = cpuTick(&emu.cpu, &emu);
  cycleCount += cycles;
  sampleAccum += cycles * SAMPLE_RATE;
  while (sampleAccum >= CPU_HZ) {
    sampleAccum -= CPU_HZ;
    audioBuf[audioLen++] = psgSample(&emu.psg);
    if (audioLen == AUDIO_BUF_LEN) {
      audioFlush();
    }
  }
  vdpAccum += cycles * VDP_HZ;
  while (vdpAccum >= CPU_HZ) {
    vdpAccum -= CPU_HZ;
    if (vdpTick(&emu.vdp, &emu)) {
      vblank();
    }
  }
  emu.cpu.irq = viaTick(&emu.via, cycles) | uartTick(&emu.uart, cycles);
  for (UInt i = 0; i < cycles; ++i) {
    ps2Tick(&emu.ps2, &emu.via, VIA_PORT_B);
    sdTick(&emu.sd, &emu.via, VIA_PORT_A);
  }
  // nmi is edge-triggered, so we must reset it
  if (emu.nmi) {
    emu.nmi = FALSE;
    emu.cpu.nmi = TRUE;
  }
}

U8 emuRead(Emu const *emu, U16 addr) {
  switch (addr) {
  case RAMLO_START_ADDR ... RAMLO_END_ADDR:
    return emu->ramlo[addr - RAMLO_START_ADDR];
  case RAMHI_START_ADDR ... RAMHI_END_ADDR:
    return emu->ramhi[viaGetC2(&emu->via, VIA_PORT_A) ? 1 : 0]
                     [addr - RAMHI_START_ADDR];
  case ROM_START_ADDR ... ROM_END_ADDR:
    return emu->rom[addr - ROM_START_ADDR];
  default:
    return 0;
  }
}

void termRawModeOn() {
  if (termRawMode) {
    return;
  }
  if (tcgetattr(STDIN_FILENO, &termiosOrig) == -1) {
    return;
  }
  struct termios raw = termiosOrig;
  cfmakeraw(&raw);
  if (tcsetattr(STDIN_FILENO, TCSAFLUSH, &raw) == -1) {
    return;
  }
  termRawMode = TRUE;
}

void termRawModeOff() {
  if (!termRawMode) {
    return;
  }
  tcsetattr(STDIN_FILENO, TCSAFLUSH, &termiosOrig);
  termRawMode = FALSE;
}
