lavignes/nop/vm/ps2.c

// SDL scancode -> PS/2 Scan Code Set 2 translation.

#include <SDL3/SDL.h>

#include "vm.h"

enum { PS2_CLK_DIV = CPU_HZ / 20000 };

typedef struct {
  U8 code;
  Bool ext;
} Ps2Code;

static Ps2Code const PS2_TBL[SDL_SCANCODE_COUNT] = {
    [SDL_SCANCODE_A] = {0x1C},
    [SDL_SCANCODE_B] = {0x32},
    [SDL_SCANCODE_C] = {0x21},
    [SDL_SCANCODE_D] = {0x23},
    [SDL_SCANCODE_E] = {0x24},
    [SDL_SCANCODE_F] = {0x2B},
    [SDL_SCANCODE_G] = {0x34},
    [SDL_SCANCODE_H] = {0x33},
    [SDL_SCANCODE_I] = {0x43},
    [SDL_SCANCODE_J] = {0x3B},
    [SDL_SCANCODE_K] = {0x42},
    [SDL_SCANCODE_L] = {0x4B},
    [SDL_SCANCODE_M] = {0x3A},
    [SDL_SCANCODE_N] = {0x31},
    [SDL_SCANCODE_O] = {0x44},
    [SDL_SCANCODE_P] = {0x4D},
    [SDL_SCANCODE_Q] = {0x15},
    [SDL_SCANCODE_R] = {0x2D},
    [SDL_SCANCODE_S] = {0x1B},
    [SDL_SCANCODE_T] = {0x2C},
    [SDL_SCANCODE_U] = {0x3C},
    [SDL_SCANCODE_V] = {0x2A},
    [SDL_SCANCODE_W] = {0x1D},
    [SDL_SCANCODE_X] = {0x22},
    [SDL_SCANCODE_Y] = {0x35},
    [SDL_SCANCODE_Z] = {0x1A},

    [SDL_SCANCODE_1] = {0x16},
    [SDL_SCANCODE_2] = {0x1E},
    [SDL_SCANCODE_3] = {0x26},
    [SDL_SCANCODE_4] = {0x25},
    [SDL_SCANCODE_5] = {0x2E},
    [SDL_SCANCODE_6] = {0x36},
    [SDL_SCANCODE_7] = {0x3D},
    [SDL_SCANCODE_8] = {0x3E},
    [SDL_SCANCODE_9] = {0x46},
    [SDL_SCANCODE_0] = {0x45},

    [SDL_SCANCODE_RETURN] = {0x5A},
    [SDL_SCANCODE_ESCAPE] = {0x76},
    [SDL_SCANCODE_BACKSPACE] = {0x66},
    [SDL_SCANCODE_TAB] = {0x0D},
    [SDL_SCANCODE_SPACE] = {0x29},
    [SDL_SCANCODE_MINUS] = {0x4E},
    [SDL_SCANCODE_EQUALS] = {0x55},
    [SDL_SCANCODE_LEFTBRACKET] = {0x54},
    [SDL_SCANCODE_RIGHTBRACKET] = {0x5B},
    [SDL_SCANCODE_BACKSLASH] = {0x5D},
    [SDL_SCANCODE_SEMICOLON] = {0x4C},
    [SDL_SCANCODE_APOSTROPHE] = {0x52},
    [SDL_SCANCODE_GRAVE] = {0x0E},
    [SDL_SCANCODE_COMMA] = {0x41},
    [SDL_SCANCODE_PERIOD] = {0x49},
    [SDL_SCANCODE_SLASH] = {0x4A},

    [SDL_SCANCODE_CAPSLOCK] = {0x58},
    [SDL_SCANCODE_LSHIFT] = {0x12},
    [SDL_SCANCODE_RSHIFT] = {0x59},
    [SDL_SCANCODE_LCTRL] = {0x14},
    [SDL_SCANCODE_LALT] = {0x11},

    [SDL_SCANCODE_F1] = {0x05},
    [SDL_SCANCODE_F2] = {0x06},
    [SDL_SCANCODE_F3] = {0x04},
    [SDL_SCANCODE_F4] = {0x0C},
    [SDL_SCANCODE_F5] = {0x03},
    [SDL_SCANCODE_F6] = {0x0B},
    [SDL_SCANCODE_F7] = {0x83},
    [SDL_SCANCODE_F8] = {0x0A},
    [SDL_SCANCODE_F9] = {0x01},
    [SDL_SCANCODE_F10] = {0x09},
    [SDL_SCANCODE_F11] = {0x78},
    [SDL_SCANCODE_F12] = {0x07},

    [SDL_SCANCODE_KP_0] = {0x70},
    [SDL_SCANCODE_KP_1] = {0x69},
    [SDL_SCANCODE_KP_2] = {0x72},
    [SDL_SCANCODE_KP_3] = {0x7A},
    [SDL_SCANCODE_KP_4] = {0x6B},
    [SDL_SCANCODE_KP_5] = {0x73},
    [SDL_SCANCODE_KP_6] = {0x74},
    [SDL_SCANCODE_KP_7] = {0x6C},
    [SDL_SCANCODE_KP_8] = {0x75},
    [SDL_SCANCODE_KP_9] = {0x7D},
    [SDL_SCANCODE_KP_PERIOD] = {0x71},
    [SDL_SCANCODE_KP_PLUS] = {0x79},
    [SDL_SCANCODE_KP_MINUS] = {0x7B},
    [SDL_SCANCODE_KP_MULTIPLY] = {0x7C},
    [SDL_SCANCODE_NUMLOCKCLEAR] = {0x77},

    [SDL_SCANCODE_RCTRL] = {0x14, TRUE},
    [SDL_SCANCODE_RALT] = {0x11, TRUE},
    [SDL_SCANCODE_LGUI] = {0x1F, TRUE},
    [SDL_SCANCODE_RGUI] = {0x27, TRUE},
    [SDL_SCANCODE_APPLICATION] = {0x2F, TRUE},
    [SDL_SCANCODE_INSERT] = {0x70, TRUE},
    [SDL_SCANCODE_DELETE] = {0x71, TRUE},
    [SDL_SCANCODE_HOME] = {0x6C, TRUE},
    [SDL_SCANCODE_END] = {0x69, TRUE},
    [SDL_SCANCODE_PAGEUP] = {0x7D, TRUE},
    [SDL_SCANCODE_PAGEDOWN] = {0x7A, TRUE},
    [SDL_SCANCODE_UP] = {0x75, TRUE},
    [SDL_SCANCODE_DOWN] = {0x72, TRUE},
    [SDL_SCANCODE_LEFT] = {0x6B, TRUE},
    [SDL_SCANCODE_RIGHT] = {0x74, TRUE},
    [SDL_SCANCODE_KP_DIVIDE] = {0x4A, TRUE},
    [SDL_SCANCODE_KP_ENTER] = {0x5A, TRUE},
};

static void ps2Push(Ps2 *ps2, U8 b) {
  U8 next = (ps2->tail + 1) % sizeof(ps2->buf);
  if (next == ps2->head) {
    return;
  }
  ps2->buf[ps2->tail] = b;
  ps2->tail = next;
}

void ps2Reset(Ps2 *ps2) {
  ps2->head = 0;
  ps2->tail = 0;
  ps2->lastTail = 0;
  ps2->pulseCycle = 0;
  ps2->pulsed = FALSE;
}

Bool ps2Pending(Ps2 const *ps2) { return ps2->head != ps2->tail; }

U8 ps2Dequeue(Ps2 *ps2) {
  if (ps2->head == ps2->tail) {
    return 0;
  }
  U8 byte = ps2->buf[ps2->head];
  ps2->head = (ps2->head + 1) % sizeof(ps2->buf);
  return byte;
}

void ps2Tick(Ps2 *ps2, Via *via, ViaPort port) {
  if (++ps2->clkDiv < PS2_CLK_DIV) {
    return;
  }
  ps2->clkDiv = 0;

  if (!ps2->pulsed && ps2->head != ps2->tail) {
    ps2->pulseCycle = 0;
    ps2->pulsed = TRUE;
  }

  if (ps2->pulsed) {
    if (ps2->pulseCycle < 10) {
      if (ps2->pulseCycle == 0) {
        U8 byte = ps2->buf[ps2->head];
        viaSetPort(via, port, byte);
      }
      viaSetC1(via, port, FALSE);
      ps2->pulseCycle++;
    } else {
      viaSetC1(via, port, TRUE);
      if (!(via->ifr & 0x10)) {
        ps2->head = (ps2->head + 1) % sizeof(ps2->buf);
        ps2->pulsed = FALSE;
      }
    }
  }
}

void ps2Key(Ps2 *ps2, UInt scancode, Bool down) {
  if ((scancode < 0) || (scancode >= SDL_SCANCODE_COUNT)) {
    return;
  }
  Ps2Code entry = PS2_TBL[scancode];
  if (entry.code == 0) {
    return;
  }
  if (entry.ext) {
    ps2Push(ps2, 0xE0);
  }
  if (!down) {
    ps2Push(ps2, 0xF0);
  }
  ps2Push(ps2, entry.code);
}
