lavignes/nop/vm/abi.h

#ifndef ABI_H
#define ABI_H

#include <inttypes.h>
#include <stdbool.h>
#include <stddef.h>
#include <stdint.h>

#define FORMAT(n)
#ifdef __has_attribute
#if __has_attribute(format)
#undef FORMAT
#define FORMAT(n) __attribute__((format(printf, (n), (n + 1))))
#endif
#endif

#define NORETURN
#ifdef __has_attribute
#if __has_attribute(noreturn)
#undef NORETURN
#define NORETURN __attribute__((noreturn))
#endif
#endif

typedef bool Bool;
#define TRUE true
#define FALSE false

typedef uint8_t U8;
typedef int8_t I8;
#define U8_MAX UINT8_MAX
#define I8_MAX INT8_MAX
#define I8_MIN INT8_MIN

#define U8_FMT PRIu8
#define I8_FMT PRIi8
#define U8_FMTX PRIx8

typedef uint16_t U16;
typedef int16_t I16;
#define U16_MAX UINT16_MAX
#define I16_MAX INT16_MAX
#define I16_MIN INT16_MIN

#define U16_FMT PRIu16
#define I16_FMT PRIi16
#define U16_FMTX PRIx16

typedef uint32_t U32;
typedef int32_t I32;
#define U32_MAX UINT32_MAX
#define I32_MAX INT32_MAX
#define I32_MIN INT32_MIN

#define U32K(K) UINT32_C(K)
#define I32K(K) INT32_C(K)
#define U32_FMT PRIu32
#define I32_FMT PRIi32
#define U32_FMTX PRIx32

typedef uint64_t U64;
typedef int64_t I64;
#define U64_MAX UINT64_MAX
#define I64_MAX INT64_MAX
#define I64_MIN INT64_MIN

#define U64K(K) UINT64_C(K)
#define I64K(K) INT64_C(K)
#define U64_FMT PRIu64
#define I64_FMT PRIi64
#define U64_FMTX PRIx64

typedef float F32;
typedef double F64;

#undef UINT_MAX
#undef INT_MAX
#undef INT_MIN

typedef uintptr_t UInt;
typedef intptr_t Int;
#define UINT_MAX UINTPTR_MAX
#define INT_MAX INTPTR_MAX
#define INT_MIN INTPTR_MIN

#if UINTPTR_MAX == UINT64_C(0xFFFFFFFFFFFFFFFF)
#define UIntK(K) UINT64_C(K)
#define UIntK(K) UINT64_C(K)
#elif UINTPTR_MAX == UINT32_C(0xFFFFFFFF)
#define UIntK(K) UINT32_C(K)
#define UIntK(K) UINT32_C(K)
#endif

#define UINT_FMT PRIuPTR
#define INT_FMT PRIiPTR
#define INT_FMTX PRIXPTR

#endif // ABI_H
