lavignes/nop/(commit log)

2025-12-22 simplification...
    but the heap is still getting corrupted. Presumably during execution of
    `#b,` within the execution of `:Def`. Need to create some checkpoint
    words for debug purposes I think. Or just insert _Panics and inspect the
    state.
2025-12-28 vm: fix ab* addressing modes
    [vm.c]
2025-12-28 vm: shortest match debug cmd
    [vm.c]
2026-01-12 vm: fix sym name matching in expressions
    [vm.c]
2026-01-15 vmsys: drivers
2026-08-14 vm: fix dis coloring
    [dbg.c, dis.c]
2026-08-30 more hardware
    [nop.kicad_pcb, nop.kicad_sch]
2026-08-30 vm: proper ps2
    [nop.kicad_sch]
2026-08-31 layout attempt 1
    [nop.kicad_pcb, nop.kicad_sch]
2026-09-03 try routing again
    [nop.kicad_pcb, nop.kicad_sch]
2026-09-04 hw: update PCB
    [nop.kicad_pcb, nop.kicad_sch]
2026-09-05 vm/hw: simplify hw. remove bank switch flip-flop in favor of VIA pin
    [nop.kicad_pcb, nop.kicad_sch]
2026-09-05 vm: stub out uart
2026-09-07 hw: complete layout
    [nop.kicad_pcb, nop.kicad_sch]
2026-09-07 hw: final?
    [nop.kicad_pcb]
2026-09-29 asm: print unrec byte vals
